Jariksp/NE555_motor_speed_control/Fusion_360/photo_2021-05-28_18-44-41.jpg

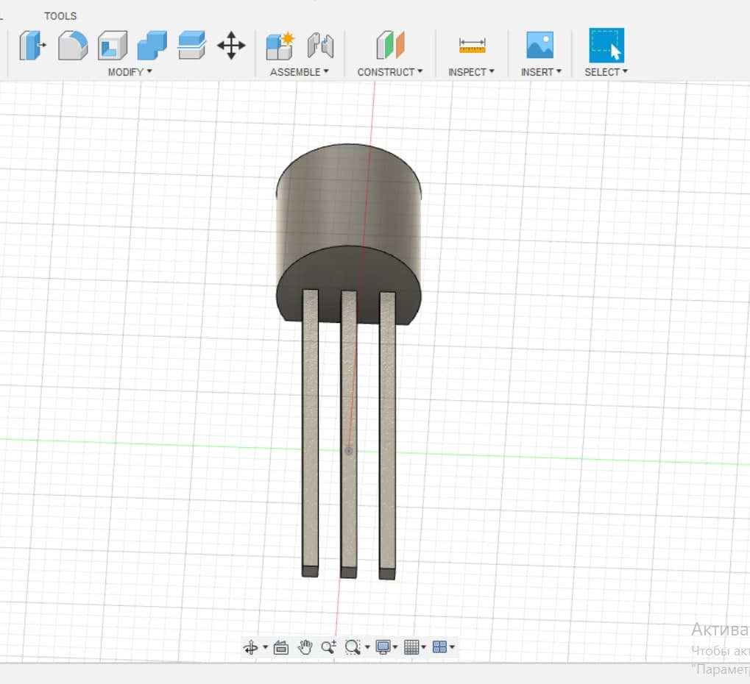
Fusion_360/photo_2021-05-28_18-44-41.jpg
