Jariksp/NE555_motor_speed_control/LTspice/photo_2021-05-28_18-51-51.jpg

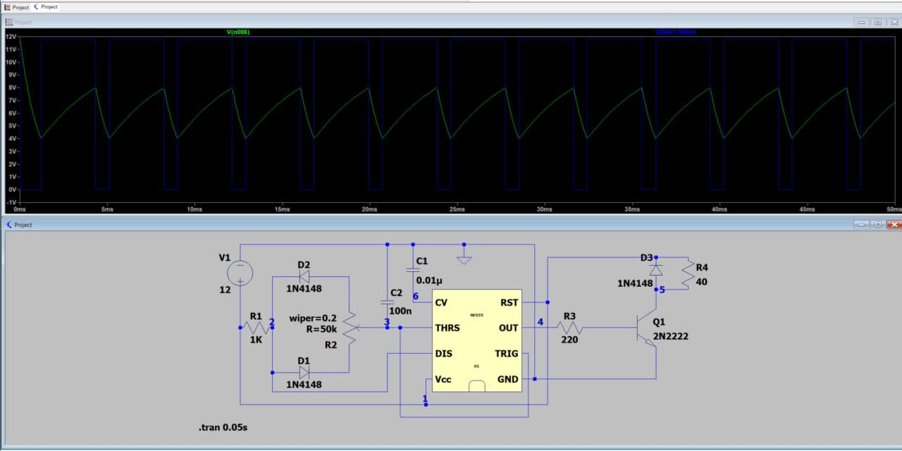
LTspice/photo_2021-05-28_18-51-51.jpg
