Jariksp/NE555_motor_speed_control/3D/1n4148.STEP

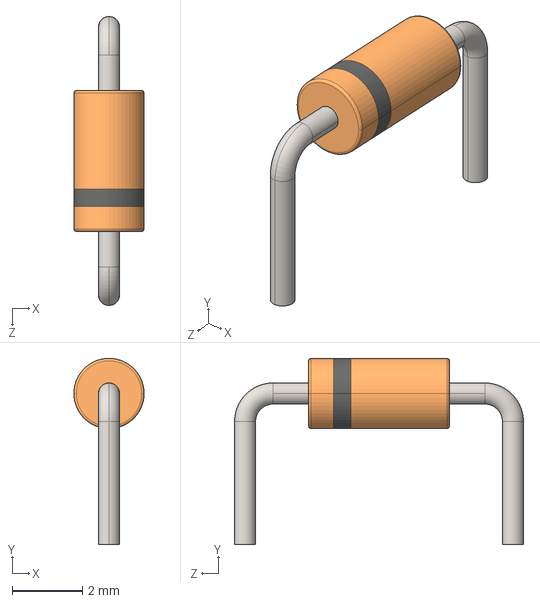
[picture p45: CAD file, 2021-05-28]
3D/1n4148.STEP
2.00 x 5.30 x 8.22 mm
