Jariksp/NE555_motor_speed_control/Fusion_360/Tran.step

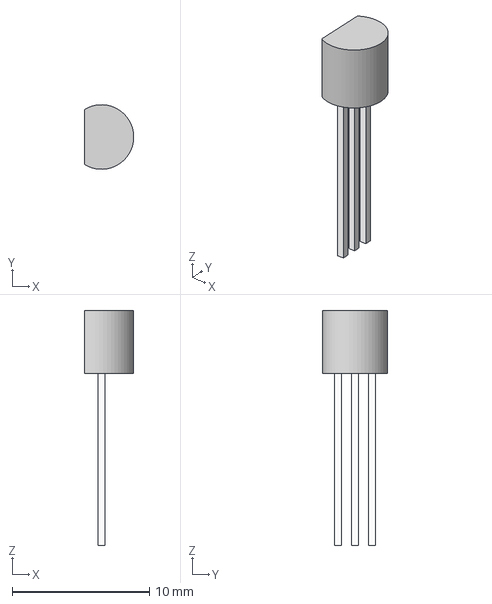
[picture p46: CAD file, 2021-05-28]
Fusion_360/Tran.step
3.60 x 4.69 x 17.1 mm
