Jariksp/NE555_motor_speed_control/3D/10K,  BOURNS 3362P-103LF.STEP

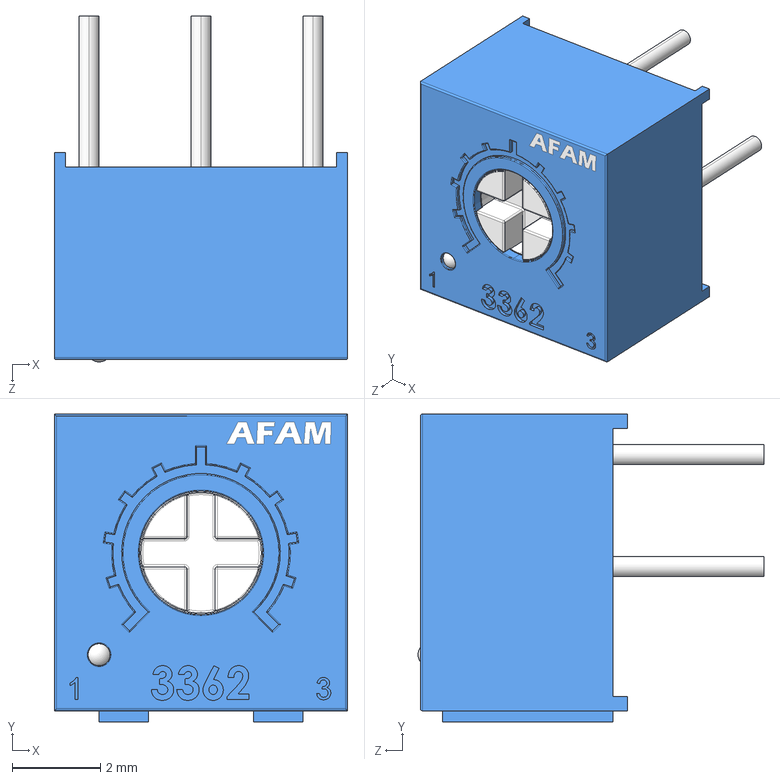
[picture p47: CAD file, 2021-05-28]
3D/10K, BOURNS 3362P-103LF.STEP
6.66 x 6.99 x 7.85 mm
