Jariksp/NE555_motor_speed_control/3D/DIP8.STEP

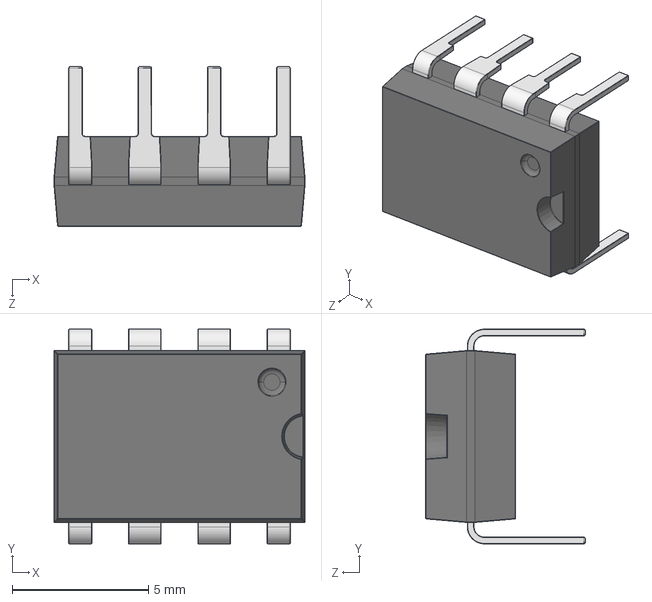
[picture p48: CAD file, 2021-05-28]
3D/DIP8.STEP
9.20 x 7.87 x 5.85 mm
