Jariksp/NE555_motor_speed_control/3D/10pF Ceramic Disc 2.SLDPRT

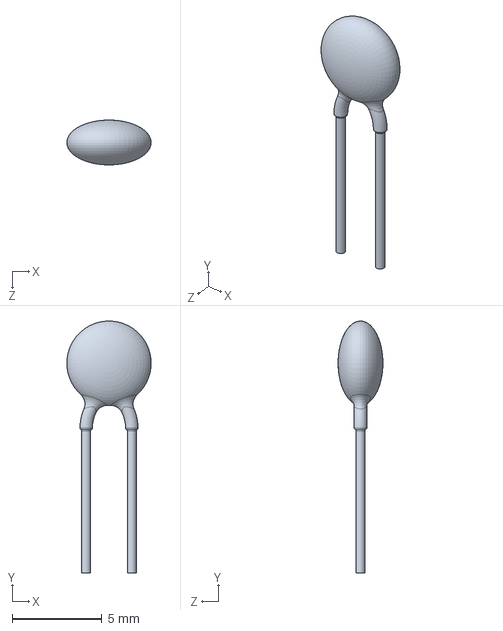
[picture p49: CAD file, 2021-05-28]
3D/10pF Ceramic Disc 2.SLDPRT
4.70 x 14.0 x 2.50 mm
