Jariksp/NE555_motor_speed_control/LTspice/Project.asc

C1: cap; 0.01µ
C2: cap; 100n
D1: diode; 1N4148
D2: diode; 1N4148
D3: diode; 1N4148
Q1: npn; 2N2222
R1: res; 1K
R2: potentiometer; R=50k
R3: res; 220
R4: res; 40
U1: NE555
V1: voltage; 12
Named nets: 0
.tran 0.05s
2
1
3
4
5
6
